bbswitzer/PianoProject/(threads)

Thread 3 (2020-11-05):

esp32 ble pairing

mpostak, 2020-11-05:
Hi Brandon,
I appreciate a lot your work, and I am trying to use it for a very similar project on a small old organ.
I'm having some issues on bonding the esp32 with android, in order to get it seen as a MIDI-output by synthesia.
I tried several times (also using "nRF Connect" or "Serial Bluetooth Terminal", also pressing the EN button) to pair the esp32 with my smartphone (and I tried with other smartphones too)... I  think I am just missing something... Do you have any ideas? (I'm using your code as it is now).
Thank you soo much,
Matteo

jord4231, 2021-01-16:
Hi Matteo having the same issue, did you work this out? I found in debug mode I can send some data but it's difficult to connect

jord4231, 2021-01-16:
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

Hi Matteo having the same issue, did you work this out? I found in debug mode I can send some data but it's difficult to connect

mpostak, 2021-01-19:
Hi!
I unfortunately do not have much free time in these months, so I still
didn't manage to look at it in the proper way...
I hope to get back to it in some weeks!!
Let me please know if you find something!

Il giorno sab 16 gen 2021 alle ore 14:09 jord4231 <notifications@github.com>
ha scritto:

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

jord4231, 2021-01-19:
Hi, yes I have got the Bluetooth to connect now. I could not get anything to pair with it in settings on the PC or android however I found if you install synthesia on an iPad and go to Bluetooth settings within the app you will find it as a midi device. This is the only way I can connect to it. I'd be curious to see your project also:)

Thread 7 (2021-03-03):

ESP32 Compilation error

mcvall, 2021-03-03:
Hi Brandon. I have Compilation error, how to solve a problem? Thanks.

C:\Arduino\PianoProject-master (1)\PianoProject-master\ESP32\ESP32.ino: In function 'void flashLED()':
ESP32:33:15: error: 'LED_BUILTIN' was not declared in this scope
  digitalWrite(LED_BUILTIN, HIGH);
               ^
C:\Arduino\PianoProject-master (1)\PianoProject-master\ESP32\ESP32.ino: In function 'void setup()':
ESP32:47:10: error: 'LED_BUILTIN' was not declared in this scope
  pinMode(LED_BUILTIN, OUTPUT);
          ^
exit status 1
'LED_BUILTIN' was not declared in this scope

jord4231, 2021-03-03:
Just define the built in led at the start of the sketch I think it's pin D9 this solved it for me.

mcvall, 2021-03-04:
I use ESP32 WROOM DevKit v1, but it not have pin D9.

bbswitzer, 2021-06-13:
Hi. Looks like your ESP32 doesn't have a built-in LED. Those lines aren't really necessary, so you can delete those or change LED_BUILTIN to a different pin.

Closed 2021-06-13.

Thread 8 (2021-03-30):

ESP32 SUSTAIN_PIN

mcvall, 2021-03-30:
Hi Brandon. How to set up the SUSTAIN_PIN correctly in the sketch? I created a new sustain PWM output: "pinMode (SUSTAIN_PIN, OUTPUT);" connected LED to PIN 13, but it doesn't work. In the port monitor (ESP32), I see that a midi signal comes from the Control box (Pro micro), all notes except SUSTAIN. I plugged in the midi keyboard, all notes work just as well except SUSTAIN.
Thanks!

void setup ()
{
const int SUSTAIN_PIN = 13;
**_pinMode (SUSTAIN_PIN, OUTPUT);_**
pinMode (LED_BUILTIN, OUTPUT);
Serial.begin (38400);
initializeBluetooth ();

// create sustain PWM output. this can't be done by the Pro Micro because the shift registers are filled up
ledcSetup (0, 100, 8);
ledcAttachPin (SUSTAIN_PIN, 0);
}

micromotores, 2022-01-17:
did you manage to do the project? Can I contact you to clarify some doubts I have?

mcvall, 2022-01-18:
Hi. The project is still in progress.  I make the solenoids myself, I also made the PCB. I hope to finish soon :) You can ask questions here.

JackZielke, 2022-06-27:
Can you tell me more about your PCB?

Thread 13 (2022-05-10):

BLE - No option to pair

DanRhys, 2022-05-10:
Hello, this was asked about before however I don't think it was solved.

After installing the correct code onto the ESP32 I though I would be able to connect my phone to the device via MIDI software, however that is not the case. There are no discoverable Bluetooth devices.

Am I missing something? Is there a specific procedure to connect to the ESP32 via Bluetooth?

I have tried different Bluetooth programs and it works perfectly.
