bbswitzer/PianoProject/ESP32/serial.h

#ifndef SERIAL_H
#define SERIAL_H

#include <Arduino.h>

void checkForSerial();
void sendMidiToProMicro(byte note, byte velocity);
void customSerialToProMicro(byte header, byte note, byte velocity);

#endif
