bbswitzer/PianoProject/(commit log)

2019-07-23 some more formatting fixes
    [note.cpp, sustain.cpp]
2019-07-31 reset repository cause it broke
    [ESP32.ino, ProMicro.ino, bluetooth.cpp, input.cpp, lcd.cpp]
2019-08-02 esp32 now receives serial from control box
2019-08-02 fixed issue where esp32 wouldn't register note off commands from control box
    [serial.cpp]
2019-08-02 piano will no longer play if volume is at 0 percent
    [note.cpp]
2020-03-24 Update ESP32.ino
    removed old test declaration
2020-05-08 Removed arbitrary pin
2020-05-08 shift register power moved to the pro micro
2020-05-08 moved shift register power pin here
2020-07-25 fixed error which caused display to scramble
    [input.cpp]
2020-10-15 Added Arduino Core to list of libraries
2020-10-20 removed character from device name
2020-11-09 device name consistency
2021-01-21 fix to PWM bug
    [shiftRegister.cpp]
2021-01-21 fix for PWM bug
    [shiftRegister.cpp]
2021-11-13 Fix handleNotes setting variable
    [settings.cpp]
2024-08-30 Add wiring diagram
